mallemann/mycnc/config/grbl/README.md

# GRBL settings

Placeholder. The GRBL settings (`$$` output) of V1–V3 will be added here later.

Until then see [config/README.md](../README.md) and the [GRBL wiki](https://github.com/gnea/grbl/wiki). Adapt every value to your own machine.
