mallemann/mycnc/.github/social-preview.png

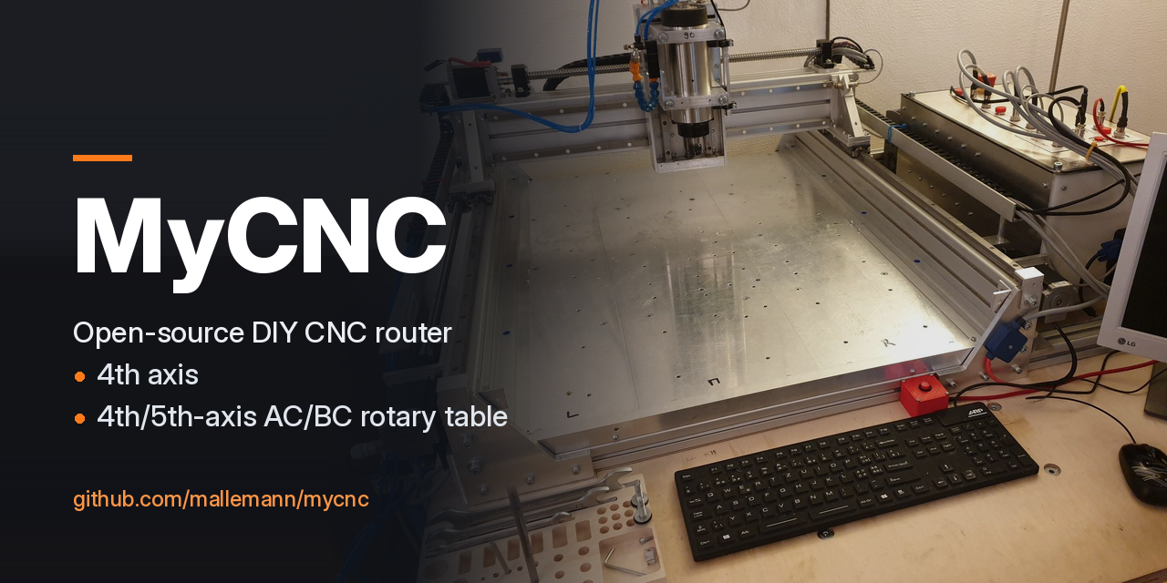
.github/social-preview.png
