mallemann/mycnc/bom/v4-structured-bom.md

# MyCNC V4 – Structured bill of materials with costs

> Generated from the Excel file [v4-structured-bom-with-costs.xlsx](v4-structured-bom-with-costs.xlsx) (original: [cnc-v4-stueckliste-mehrstufig.xlsx](https://masdrive.ch/myprojects/assets/media/2026/10/cnc-v4-stueckliste-mehrstufig.xlsx)). The nicest way to browse it – with thumbnail images – is the **[interactive view on masdrive](https://masdrive.ch/myprojects/projects/cnc-platform/#stueckliste)**.

Exported from the CAD model; all values (quantities, costs in USD, names, materials, sources) are taken unchanged from the Excel file. Part names are partly German. Costs are meant as an orientation only.

**Total cost V4 (as stated in the file): $4,238.30**

237 items in 4 levels · 8 main assemblies · 41 assemblies with sub-items (incl. the main assemblies)

## Main assemblies

| Pos. | Main assembly | Part number | Qty | Unit cost | Total |
|---|---|---|---:|---:|---:|
| 1 | Y1 Axis | SW-00070 | 1 | $295.40 | $295.40 |
| 2 | Fräskopf | SW-00087 | 1 | $511.30 | $511.30 |
| 3 | Y2 Axis | SW-00086 | 1 | $295.00 | $295.00 |
| 4 | Generic 6 Axis Controller | SW-00021 | 1 | $1,282.20 | $1,282.20 |
| 5 | Basis | SW-00007 | 1 | $65.10 | $65.10 |
| 6 | PLH3D-15W High Performance Plug&Play Laser Kit for All CNC Machines | SW-00148 | 1 | $700.00 | $700.00 |
| 7 | X Axis | SW-00104 | 1 | $571.80 | $571.80 |
| 8 | Z Axis | SW-00122 | 1 | $517.50 | $517.50 |
| | **Total (as stated in the file)** | | | | **$4,238.30** |

## Full structure

Click an assembly to expand it. Format: position, name, part number, quantity × unit cost = total.

<ul>
  <li><details><summary><b>1</b> Y1 Axis · <code>SW-00070</code> · 1 × $295.40 = <b>$295.40</b></summary>
  <ul>
    <li><b>1.1</b> LagerMotorHalterWinkel · <code>SW-00071</code> · 1 × $1.00 = <b>$1.00</b> · Material: 1060 Legierung</li>
    <li><b>1.2</b> 120x40-960 · <code>SW-00077</code> · 1 × $5.00 = <b>$5.00</b> · Material: 1060 Legierung</li>
    <li><details><summary><b>1.3</b> FestLager · <code>SW-00078</code> · 1 × $39.50 = <b>$39.50</b> · Source: <a href="https://www.dold-mechatronik.de/">dold-mechatronik.de</a></summary>
    <ul>
      <li><b>1.3.1</b> LagerMutterM10 · <code>SW-00079</code> · 1 × $0.10 = <b>$0.10</b> · Material: 201 Gehärteter Edelstahl (SS)</li>
      <li><b>1.3.2</b> FestLagerDeckel · <code>SW-00080</code> · 1 × $4.00 = <b>$4.00</b> · Material: 1023 Kohlenstoffstahlblech (SS)</li>
      <li><b>1.3.3</b> FestLagerBock · <code>SW-00081</code> · 1 × $25.00 = <b>$25.00</b> · Material: 1023 Kohlenstoffstahlblech (SS)</li>
      <li><b>1.3.4</b> SchraegLager10x30x14.3-Dold · <code>SW-00082</code> · 1 × $10.00 = <b>$10.00</b></li>
      <li><b>1.3.5</b> DIN 912 M5 x 20 --- 20N · <code>DIN 912 M5 x 20 --- 20N</code> · 4 × $0.10 = <b>$0.40</b></li>
    </ul>
    </details></li>
    <li><b>1.4</b> LagerHalterPlatteY · <code>SW-00083</code> · 1 × $1.00 = <b>$1.00</b></li>
    <li><details><summary><b>1.5</b> LosLager · <code>SW-00072</code> · 1 × $19.00 = <b>$19.00</b> · Source: <a href="https://www.dold-mechatronik.de/">dold-mechatronik.de</a></summary>
    <ul>
      <li><b>1.5.1</b> LosLagerBock · <code>SW-00073</code> · 1 × $12.00 = <b>$12.00</b> · Material: 1023 Kohlenstoffstahlblech (SS)</li>
      <li><b>1.5.2</b> KugelLagerLager10x30x9-Dold · <code>SW-00074</code> · 1 × $7.00 = <b>$7.00</b></li>
    </ul>
    </details></li>
    <li><b>1.6</b> WellenKupplung6.35-8Dold · <code>SW-00084</code> · 1 × $3.00 = <b>$3.00</b> · Material: 1060 Legierung · Source: <a href="https://www.dold-mechatronik.de/">dold-mechatronik.de</a></li>
    <li><b>1.7</b> GewindeSpindel16x5x842 · <code>SW-00075</code> · 1 × $50.00 = <b>$50.00</b> · Material: Rostfreier Chromstahl · Source: <a href="https://www.dold-mechatronik.de/">dold-mechatronik.de</a></li>
    <li><b>1.8</b> AR15-rail 960 · <code>SW-00076</code> · 1 × $64.00 = <b>$64.00</b> · Material: 1.5714 (16NiCr4) · Source: <a href="https://www.dold-mechatronik.de/">dold-mechatronik.de</a></li>
    <li><b>1.9</b> DIN 912 M6 x 10 --- 10N · <code>DIN 912 M6 x 10 --- 10N</code> · 12 × $0.10 = <b>$1.20</b></li>
    <li><b>1.10</b> DIN 912 M4 x 6 --- 6N · <code>DIN 912 M4 x 6 --- 6N</code> · 18 × $0.10 = <b>$1.80</b></li>
    <li><b>1.11</b> DIN 912 M5 x 20 --- 20N · <code>DIN 912 M5 x 20 --- 20N</code> · 4 × $0.10 = <b>$0.40</b></li>
    <li><b>1.12</b> ISO - 4033 - M5 - W - N · <code>ISO - 4033 - M5 - W - N</code> · 4 × $0.10 = <b>$0.40</b></li>
    <li><b>1.13</b> Circlip DIN 471 - 10 x 1 · <code>Circlip DIN 471 - 10 x 1</code> · 1 × $0.10 = <b>$0.10</b></li>
    <li><b>1.14</b> Closed Loop Stepper 3.6 NM on X Axis, 3NM Bipolar Stepper 3NM on Y1,Y2 and Z Axis · <code>SW-00085</code> · 1 × $109.00 = <b>$109.00</b> · Source: ebay</li>
  </ul>
  </details></li>
  <li><details><summary><b>2</b> Fräskopf · <code>SW-00087</code> · 1 × $511.30 = <b>$511.30</b></summary>
  <ul>
    <li><b>2.1</b> ARC15FN_block · <code>SW-00090</code> · 4 × $30.00 = <b>$120.00</b> · Source: <a href="https://www.dold-mechatronik.de/">dold-mechatronik.de</a></li>
    <li><b>2.2</b> MotorHalter1 · <code>SW-00089</code> · 2 × $1.00 = <b>$2.00</b> · Material: 1060 Legierung</li>
    <li><b>2.3</b> Spindle GDZ-23 · <code>SW-00092</code> · 1 × $250.00 = <b>$250.00</b> · Source: ebay</li>
    <li><details><summary><b>2.4</b> CamHalter3 · <code>SW-00093</code> · 1 × $5.20 = <b>$5.20</b></summary>
    <ul>
      <li><b>2.4.1</b> Cam · <code>SW-00094</code> · 1 × $5.00 = <b>$5.00</b> · Material: 1.5805 (10NiCr5-4)</li>
      <li><b>2.4.2</b> CamHUnten · <code>SW-00095</code> · 1 × $0.10 = <b>$0.10</b></li>
      <li><b>2.4.3</b> CamHOben · <code>SW-00096</code> · 1 × $0.10 = <b>$0.10</b></li>
    </ul>
    </details></li>
    <li><b>2.5</b> MotorHalterPlatteIsel · <code>SW-00088</code> · 1 × $1.00 = <b>$1.00</b> · Material: 1060 Legierung</li>
    <li><b>2.6</b> MotorHalter2 · <code>SW-00091</code> · 2 × $1.00 = <b>$2.00</b> · Material: 1060 Legierung</li>
    <li><details><summary><b>2.7</b> spannblock_-_213400 · <code>SW-00097</code> · 1 × $127.30 = <b>$127.30</b> · Source: <a href="https://www.dold-mechatronik.de/">dold-mechatronik.de</a></summary>
    <ul>
      <li><b>2.7.1</b> spannblock_-_213400_01 · <code>SW-00099</code> · 1 × $48.00 = <b>$48.00</b> · Source: <a href="https://www.dold-mechatronik.de/">dold-mechatronik.de</a></li>
      <li><b>2.7.2</b> spannblock_-_213400_03 · <code>SW-00101</code> · 1 × $0.10 = <b>$0.10</b></li>
      <li><b>2.7.3</b> spannblock_-_213400_04 · <code>SW-00100</code> · 1 × $0.10 = <b>$0.10</b></li>
      <li><b>2.7.4</b> spannblock_-_213400_02 · <code>SW-00098</code> · 1 × $0.10 = <b>$0.10</b></li>
      <li><b>2.7.5</b> Kugelgewindemutter 12x2,5mm, Einzelgangrückführung von Dold Mechatronic · <code>SW-00102</code> · 1 × $79.00 = <b>$79.00</b> · Material: 1.4000 (X6Cr13)</li>
    </ul>
    </details></li>
    <li><b>2.8</b> DIN 912 M8 x 80 --- 28N · <code>DIN 912 M8 x 80 --- 28N</code> · 4 × $0.10 = <b>$0.40</b></li>
    <li><b>2.9</b> DIN 912 M5 x 20 --- 20N · <code>DIN 912 M5 x 20 --- 20N</code> · 16 × $0.10 = <b>$1.60</b></li>
    <li><b>2.10</b> DIN 912 M4 x 16 --- 16N · <code>DIN 912 M4 x 16 --- 16N</code> · 4 × $0.10 = <b>$0.40</b></li>
    <li><b>2.11</b> DIN 912 M5 x 35 --- 22N · <code>DIN 912 M5 x 35 --- 22N</code> · 4 × $0.10 = <b>$0.40</b></li>
    <li><b>2.12</b> LaserHalter1 · <code>SW-00103</code> · 1 × $1.00 = <b>$1.00</b></li>
  </ul>
  </details></li>
  <li><details><summary><b>3</b> Y2 Axis · <code>SW-00086</code> · 1 × $295.00 = <b>$295.00</b></summary>
  <ul>
    <li><b>3.1</b> AR15-rail 960 · <code>SW-00076</code> · 1 × $64.00 = <b>$64.00</b> · Material: 1.5714 (16NiCr4) · Source: <a href="https://www.dold-mechatronik.de/">dold-mechatronik.de</a></li>
    <li><details><summary><b>3.2</b> FestLager · <code>SW-00078</code> · 1 × $39.50 = <b>$39.50</b> · Source: <a href="https://www.dold-mechatronik.de/">dold-mechatronik.de</a></summary>
    <ul>
      <li><b>3.2.1</b> LagerMutterM10 · <code>SW-00079</code> · 1 × $0.10 = <b>$0.10</b> · Material: 201 Gehärteter Edelstahl (SS)</li>
      <li><b>3.2.2</b> FestLagerDeckel · <code>SW-00080</code> · 1 × $4.00 = <b>$4.00</b> · Material: 1023 Kohlenstoffstahlblech (SS)</li>
      <li><b>3.2.3</b> FestLagerBock · <code>SW-00081</code> · 1 × $25.00 = <b>$25.00</b> · Material: 1023 Kohlenstoffstahlblech (SS)</li>
      <li><b>3.2.4</b> SchraegLager10x30x14.3-Dold · <code>SW-00082</code> · 1 × $10.00 = <b>$10.00</b></li>
      <li><b>3.2.5</b> DIN 912 M5 x 20 --- 20N · <code>DIN 912 M5 x 20 --- 20N</code> · 4 × $0.10 = <b>$0.40</b></li>
    </ul>
    </details></li>
    <li><b>3.3</b> 120x40-960 · <code>SW-00077</code> · 1 × $5.00 = <b>$5.00</b> · Material: 1060 Legierung</li>
    <li><b>3.4</b> DIN 912 M6 x 10 --- 10N · <code>DIN 912 M6 x 10 --- 10N</code> · 12 × $0.10 = <b>$1.20</b></li>
    <li><details><summary><b>3.5</b> LosLager · <code>SW-00072</code> · 1 × $19.00 = <b>$19.00</b> · Source: <a href="https://www.dold-mechatronik.de/">dold-mechatronik.de</a></summary>
    <ul>
      <li><b>3.5.1</b> LosLagerBock · <code>SW-00073</code> · 1 × $12.00 = <b>$12.00</b> · Material: 1023 Kohlenstoffstahlblech (SS)</li>
      <li><b>3.5.2</b> KugelLagerLager10x30x9-Dold · <code>SW-00074</code> · 1 × $7.00 = <b>$7.00</b></li>
    </ul>
    </details></li>
    <li><b>3.6</b> GewindeSpindel16x5x842 · <code>SW-00075</code> · 1 × $50.00 = <b>$50.00</b> · Material: Rostfreier Chromstahl · Source: <a href="https://www.dold-mechatronik.de/">dold-mechatronik.de</a></li>
    <li><b>3.7</b> LagerMotorHalterWinkel · <code>SW-00071</code> · 1 × $1.00 = <b>$1.00</b> · Material: 1060 Legierung</li>
    <li><b>3.8</b> WellenKupplung6.35-8Dold · <code>SW-00084</code> · 1 × $3.00 = <b>$3.00</b> · Material: 1060 Legierung · Source: <a href="https://www.dold-mechatronik.de/">dold-mechatronik.de</a></li>
    <li><b>3.9</b> LagerHalterPlatteY · <code>SW-00083</code> · 1 × $1.00 = <b>$1.00</b></li>
    <li><b>3.10</b> Closed Loop Stepper 3.6 NM on X Axis, 3NM Bipolar Stepper 3NM on Y1,Y2 and Z Axis · <code>SW-00085</code> · 1 × $109.00 = <b>$109.00</b> · Source: ebay</li>
    <li><b>3.11</b> DIN 912 M4 x 10 --- 10N · <code>DIN 912 M4 x 10 --- 10N</code> · 16 × $0.10 = <b>$1.60</b></li>
    <li><b>3.12</b> Circlip DIN 471 - 10 x 1 · <code>Circlip DIN 471 - 10 x 1</code> · 1 × $0.10 = <b>$0.10</b></li>
    <li><b>3.13</b> DIN 912 M5 x 20 --- 20N · <code>DIN 912 M5 x 20 --- 20N</code> · 4 × $0.10 = <b>$0.40</b></li>
    <li><b>3.14</b> DIN 912 M4 x 16 --- 16N · <code>DIN 912 M4 x 16 --- 16N</code> · 2 × $0.10 = <b>$0.20</b></li>
  </ul>
  </details></li>
  <li><details><summary><b>4</b> Generic 6 Axis Controller · <code>SW-00021</code> · 1 × $1,282.20 = <b>$1,282.20</b></summary>
  <ul>
    <li><details><summary><b>4.1</b> Boards · <code>SW-00028</code> · 1 × $348.00 = <b>$348.00</b></summary>
    <ul>
      <li><b>4.1.1</b> UB1 motherboard from cncroom · <code>SW-00029</code> · 1 × $196.00 = <b>$196.00</b> · Source: <a href="https://cncroom.com/en/">cncroom.com/en</a></li>
      <li><b>4.1.2</b> UC300ETH-5LPT MOtion Controller from CNCDrive · <code>SW-00030</code> · 1 × $152.00 = <b>$152.00</b> · Source: <a href="https://www.cncdrive.com/">cncdrive.com</a></li>
    </ul>
    </details></li>
    <li><details><summary><b>4.2</b> Driver · <code>SW-00049</code> · 1 × $330.00 = <b>$330.00</b></summary>
    <ul>
      <li><b>4.2.1</b> DQ542MA CNC Digital Stepper Motor Controller 50V/4.2A/128 Micro · <code>SW-00050</code> · 6 × $55.00 = <b>$330.00</b> · Source: ebay</li>
    </ul>
    </details></li>
    <li><details><summary><b>4.3</b> Stecker · <code>SW-00031</code> · 1 × $43.80 = <b>$43.80</b></summary>
    <ul>
      <li><details><summary><b>4.3.1</b> Buchse2P v2 · <code>SW-00039</code> · 1 × $1.20 = <b>$1.20</b></summary>
      <ul>
        <li><b>4.3.1.1</b> 4 pin aviation f · <code>SW-00033</code> · 1 × $0.50 = <b>$0.50</b></li>
        <li><b>4.3.1.2</b> 4 pin aviation spring washer · <code>SW-00035</code> · 1 × $0.10 = <b>$0.10</b></li>
        <li><b>4.3.1.3</b> 2 pin aviation f plastic · <code>SW-00034</code> · 1 × $0.50 = <b>$0.50</b></li>
        <li><b>4.3.1.4</b> 4 pin aviation nut · <code>SW-00036</code> · 1 × $0.10 = <b>$0.10</b></li>
      </ul>
      </details></li>
      <li><details><summary><b>4.3.2</b> Buchse4P v2 · <code>SW-00041</code> · 6 × $5.70 = <b>$34.20</b></summary>
      <ul>
        <li><b>4.3.2.1</b> 4 pin aviation f plastic · <code>SW-00043</code> · 1 × $0.50 = <b>$0.50</b></li>
        <li><b>4.3.2.2</b> 4 pin aviation f-1 · <code>SW-00042</code> · 1 × $5.00 = <b>$5.00</b></li>
        <li><b>4.3.2.3</b> 4 pin aviation spring washer-1 · <code>SW-00044</code> · 1 × $0.10 = <b>$0.10</b></li>
        <li><b>4.3.2.4</b> 4 pin aviation nut-1 · <code>SW-00045</code> · 1 × $0.10 = <b>$0.10</b></li>
      </ul>
      </details></li>
      <li><details><summary><b>4.3.3</b> Buchse2P v2-1 · <code>SW-00040</code> · 1 × $1.20 = <b>$1.20</b></summary>
      <ul>
        <li><b>4.3.3.1</b> 4 pin aviation f · <code>SW-00033</code> · 1 × $0.50 = <b>$0.50</b></li>
        <li><b>4.3.3.2</b> 4 pin aviation spring washer · <code>SW-00035</code> · 1 × $0.10 = <b>$0.10</b></li>
        <li><b>4.3.3.3</b> 4 pin aviation nut · <code>SW-00036</code> · 1 × $0.10 = <b>$0.10</b></li>
        <li><b>4.3.3.4</b> 2 pin aviation f plastic · <code>SW-00034</code> · 1 × $0.50 = <b>$0.50</b></li>
      </ul>
      </details></li>
      <li><details><summary><b>4.3.4</b> Buchse2P v2-3 · <code>SW-00047</code> · 1 × $1.20 = <b>$1.20</b></summary>
      <ul>
        <li><b>4.3.4.1</b> 2 pin aviation f plastic · <code>SW-00034</code> · 1 × $0.50 = <b>$0.50</b></li>
        <li><b>4.3.4.2</b> 4 pin aviation f · <code>SW-00033</code> · 1 × $0.50 = <b>$0.50</b></li>
        <li><b>4.3.4.3</b> 4 pin aviation spring washer · <code>SW-00035</code> · 1 × $0.10 = <b>$0.10</b></li>
        <li><b>4.3.4.4</b> 4 pin aviation nut · <code>SW-00036</code> · 1 × $0.10 = <b>$0.10</b></li>
      </ul>
      </details></li>
      <li><details><summary><b>4.3.5</b> Buchse2P v2-2 · <code>SW-00046</code> · 1 × $1.20 = <b>$1.20</b></summary>
      <ul>
        <li><b>4.3.5.1</b> 4 pin aviation spring washer · <code>SW-00035</code> · 1 × $0.10 = <b>$0.10</b></li>
        <li><b>4.3.5.2</b> 4 pin aviation nut · <code>SW-00036</code> · 1 × $0.10 = <b>$0.10</b></li>
        <li><b>4.3.5.3</b> 2 pin aviation f plastic · <code>SW-00034</code> · 1 × $0.50 = <b>$0.50</b></li>
        <li><b>4.3.5.4</b> 4 pin aviation f · <code>SW-00033</code> · 1 × $0.50 = <b>$0.50</b></li>
      </ul>
      </details></li>
      <li><details><summary><b>4.3.6</b> Buchse2P v2-4 · <code>SW-00032</code> · 1 × $1.20 = <b>$1.20</b></summary>
      <ul>
        <li><b>4.3.6.1</b> 4 pin aviation f · <code>SW-00033</code> · 1 × $0.50 = <b>$0.50</b></li>
        <li><b>4.3.6.2</b> 4 pin aviation nut · <code>SW-00036</code> · 1 × $0.10 = <b>$0.10</b></li>
        <li><b>4.3.6.3</b> 2 pin aviation f plastic · <code>SW-00034</code> · 1 × $0.50 = <b>$0.50</b></li>
        <li><b>4.3.6.4</b> 4 pin aviation spring washer · <code>SW-00035</code> · 1 × $0.10 = <b>$0.10</b></li>
      </ul>
      </details></li>
      <li><details><summary><b>4.3.7</b> Buchse2P v2-7 · <code>SW-00038</code> · 1 × $1.20 = <b>$1.20</b></summary>
      <ul>
        <li><b>4.3.7.1</b> 2 pin aviation f plastic · <code>SW-00034</code> · 1 × $0.50 = <b>$0.50</b></li>
        <li><b>4.3.7.2</b> 4 pin aviation nut · <code>SW-00036</code> · 1 × $0.10 = <b>$0.10</b></li>
        <li><b>4.3.7.3</b> 4 pin aviation f · <code>SW-00033</code> · 1 × $0.50 = <b>$0.50</b></li>
        <li><b>4.3.7.4</b> 4 pin aviation spring washer · <code>SW-00035</code> · 1 × $0.10 = <b>$0.10</b></li>
      </ul>
      </details></li>
      <li><details><summary><b>4.3.8</b> Buchse2P v2-6 · <code>SW-00037</code> · 1 × $1.20 = <b>$1.20</b></summary>
      <ul>
        <li><b>4.3.8.1</b> 4 pin aviation f · <code>SW-00033</code> · 1 × $0.50 = <b>$0.50</b></li>
        <li><b>4.3.8.2</b> 2 pin aviation f plastic · <code>SW-00034</code> · 1 × $0.50 = <b>$0.50</b></li>
        <li><b>4.3.8.3</b> 4 pin aviation spring washer · <code>SW-00035</code> · 1 × $0.10 = <b>$0.10</b></li>
        <li><b>4.3.8.4</b> 4 pin aviation nut · <code>SW-00036</code> · 1 × $0.10 = <b>$0.10</b></li>
      </ul>
      </details></li>
      <li><details><summary><b>4.3.9</b> Buchse2P v2-5 · <code>SW-00048</code> · 1 × $1.20 = <b>$1.20</b></summary>
      <ul>
        <li><b>4.3.9.1</b> 4 pin aviation nut · <code>SW-00036</code> · 1 × $0.10 = <b>$0.10</b></li>
        <li><b>4.3.9.2</b> 2 pin aviation f plastic · <code>SW-00034</code> · 1 × $0.50 = <b>$0.50</b></li>
        <li><b>4.3.9.3</b> 4 pin aviation spring washer · <code>SW-00035</code> · 1 × $0.10 = <b>$0.10</b></li>
        <li><b>4.3.9.4</b> 4 pin aviation f · <code>SW-00033</code> · 1 × $0.50 = <b>$0.50</b></li>
      </ul>
      </details></li>
    </ul>
    </details></li>
    <li><details><summary><b>4.4</b> Gehaeuse-Profil v40 · <code>SW-00052</code> · 1 × $58.40 = <b>$58.40</b></summary>
    <ul>
      <li><b>4.4.1</b> 30x30-224 v2 · <code>SW-00053</code> · 4 × $5.00 = <b>$20.00</b> · Material: 3.3547 (EN-AW 5083)</li>
      <li><b>4.4.2</b> FanDeckel · <code>SW-00068</code> · 1 × $1.00 = <b>$1.00</b></li>
      <li><details><summary><b>4.4.3</b> Hutschienen · <code>SW-00055</code> · 1 × $4.00 = <b>$4.00</b></summary>
      <ul>
        <li><b>4.4.3.1</b> Schiene · <code>SW-00056</code> · 2 × $2.00 = <b>$4.00</b></li>
      </ul>
      </details></li>
      <li><b>4.4.4</b> WandGeraeteStecker_1 · <code>SW-00066</code> · 1 × $1.00 = <b>$1.00</b> · Material: 1060 Legierung</li>
      <li><b>4.4.5</b> Boden · <code>SW-00057</code> · 1 × $1.00 = <b>$1.00</b></li>
      <li><b>4.4.6</b> WandPlexi · <code>SW-00054</code> · 1 × $1.00 = <b>$1.00</b> · Material: Glas</li>
      <li><details><summary><b>4.4.7</b> Schrauben · <code>SW-00060</code> · 1 × $2.40 = <b>$2.40</b></summary>
      <ul>
        <li><b>4.4.7.1</b> 91292A116 · <code>SW-00062</code> · 16 × $0.10 = <b>$1.60</b></li>
        <li><b>4.4.7.2</b> 91239A412 · <code>SW-00061</code> · 4 × $0.10 = <b>$0.40</b></li>
        <li><b>4.4.7.3</b> 9546K241 · <code>SW-00063</code> · 4 × $0.10 = <b>$0.40</b></li>
      </ul>
      </details></li>
      <li><b>4.4.8</b> WandDriver · <code>SW-00058</code> · 1 × $1.00 = <b>$1.00</b> · Material: 1060 Legierung</li>
      <li><b>4.4.9</b> WandKurz2_1 · <code>SW-00059</code> · 1 × $1.00 = <b>$1.00</b> · Material: 1060 Legierung</li>
      <li><b>4.4.10</b> Deckel · <code>SW-00065</code> · 1 × $1.00 = <b>$1.00</b> · Material: 1060 Legierung</li>
      <li><b>4.4.11</b> power socket w fuse v1 · <code>SW-00064</code> · 1 × $5.00 = <b>$5.00</b></li>
      <li><b>4.4.12</b> E-StopAutomationDirectGCX1131 v1 · <code>SW-00067</code> · 1 × $10.00 = <b>$10.00</b></li>
      <li><b>4.4.13</b> GDSTIME 50mm x 50mm x 20mm 12V Brushless Cooling Fan v2 · <code>SW-00069</code> · 1 × $10.00 = <b>$10.00</b></li>
    </ul>
    </details></li>
    <li><details><summary><b>4.5</b> Power Supply · <code>SW-00022</code> · 1 × $152.00 = <b>$152.00</b></summary>
    <ul>
      <li><b>4.5.1</b> wago_222_5_terminal v1 · <code>SW-00026</code> · 3 × $1.00 = <b>$3.00</b></li>
      <li><b>4.5.2</b> 48V Power Supply for Stepper · <code>SW-00024</code> · 2 × $45.00 = <b>$90.00</b> · Source: ebay</li>
      <li><b>4.5.3</b> 5V Power Supply · <code>SW-00025</code> · 1 × $25.00 = <b>$25.00</b> · Source: ebay</li>
      <li><b>4.5.4</b> 24V Power Supply for UB1 motion controller · <code>SW-00023</code> · 1 × $22.00 = <b>$22.00</b> · Source: ebay</li>
      <li><b>4.5.5</b> 12V Power Supply for Laser Module · <code>SW-00027</code> · 1 × $12.00 = <b>$12.00</b> · Source: ebay</li>
    </ul>
    </details></li>
    <li><b>4.6</b> Windows 11 PC für UCCNC · <code>SW-00051</code> · 1 × $350.00 = <b>$350.00</b></li>
  </ul>
  </details></li>
  <li><details><summary><b>5</b> Basis · <code>SW-00007</code> · 1 × $65.10 = <b>$65.10</b></summary>
  <ul>
    <li><b>5.1</b> 40x40-1100 · <code>SW-00008</code> · 5 × $5.00 = <b>$25.00</b> · Material: 1060 Legierung</li>
    <li><b>5.2</b> 160x150x40x10 · <code>SW-00010</code> · 4 × $1.00 = <b>$4.00</b> · Material: 1060 Legierung</li>
    <li><b>5.3</b> 8x70x960 · <code>SW-00011</code> · 1 × $2.00 = <b>$2.00</b> · Material: 1060 Legierung</li>
    <li><b>5.4</b> Winkel40x40x8 · <code>SW-00009</code> · 1 × $2.00 = <b>$2.00</b> · Material: 1060 Legierung</li>
    <li><b>5.5</b> Halter · <code>SW-00013</code> · 2 × $0.10 = <b>$0.20</b></li>
    <li><b>5.6</b> SteuerungDistanzhalter · <code>SW-00012</code> · 2 × $0.10 = <b>$0.20</b></li>
    <li><details><summary><b>5.7</b> Schrauben^BasisGestell · <code>SW-00014</code> · 1 × $8.70 = <b>$8.70</b></summary>
    <ul>
      <li><b>5.7.1</b> DIN 7991 - M6 x 20 --- 13.7N · <code>DIN 7991 - M6 x 20 --- 13.7N</code> · 25 × $0.10 = <b>$2.50</b></li>
      <li><b>5.7.2</b> DIN 912 M6 x 10 --- 10N · <code>DIN 912 M6 x 10 --- 10N</code> · 50 × $0.10 = <b>$5.00</b></li>
      <li><b>5.7.3</b> DIN 912 M8 x 12 --- 12N · <code>DIN 912 M8 x 12 --- 12N</code> · 12 × $0.10 = <b>$1.20</b></li>
    </ul>
    </details></li>
    <li><b>5.8</b> GrundgestellVerstärker · <code>SW-00015</code> · 2 × $2.00 = <b>$4.00</b> · Material: 1060 Legierung</li>
    <li><details><summary><b>5.9</b> AluBP · <code>SW-00017</code> · 1 × $3.00 = <b>$3.00</b></summary>
    <ul>
      <li><b>5.9.1</b> AluBP150 · <code>SW-00019</code> · 1 × $1.00 = <b>$1.00</b> · Material: 1060 Legierung</li>
      <li><b>5.9.2</b> AluBP250 · <code>SW-00018</code> · 2 × $1.00 = <b>$2.00</b> · Material: 1060 Legierung</li>
    </ul>
    </details></li>
    <li><b>5.10</b> InduktivSensor · <code>SW-00016</code> · 1 × $15.00 = <b>$15.00</b> · Source: <a href="https://www.dold-mechatronik.de/">dold-mechatronik.de</a></li>
    <li><b>5.11</b> SensorPlatte · <code>SW-00020</code> · 1 × $1.00 = <b>$1.00</b> · Material: 3.3547 (EN-AW 5083)</li>
  </ul>
  </details></li>
  <li><b>6</b> PLH3D-15W High Performance Plug&amp;Play Laser Kit for All CNC Machines · <code>SW-00148</code> · 1 × $700.00 = <b>$700.00</b> · Source: <a href="https://optlasers.com/">optlasers.com</a></li>
  <li><details><summary><b>7</b> X Axis · <code>SW-00104</code> · 1 × $571.80 = <b>$571.80</b></summary>
  <ul>
    <li><details><summary><b>7.1</b> FestLager · <code>SW-00078</code> · 1 × $39.50 = <b>$39.50</b> · Source: <a href="https://www.dold-mechatronik.de/">dold-mechatronik.de</a></summary>
    <ul>
      <li><b>7.1.1</b> LagerMutterM10 · <code>SW-00079</code> · 1 × $0.10 = <b>$0.10</b> · Material: 201 Gehärteter Edelstahl (SS)</li>
      <li><b>7.1.2</b> FestLagerDeckel · <code>SW-00080</code> · 1 × $4.00 = <b>$4.00</b> · Material: 1023 Kohlenstoffstahlblech (SS)</li>
      <li><b>7.1.3</b> FestLagerBock · <code>SW-00081</code> · 1 × $25.00 = <b>$25.00</b> · Material: 1023 Kohlenstoffstahlblech (SS)</li>
      <li><b>7.1.4</b> SchraegLager10x30x14.3-Dold · <code>SW-00082</code> · 1 × $10.00 = <b>$10.00</b></li>
      <li><b>7.1.5</b> DIN 912 M5 x 20 --- 20N · <code>DIN 912 M5 x 20 --- 20N</code> · 4 × $0.10 = <b>$0.40</b></li>
    </ul>
    </details></li>
    <li><b>7.2</b> DIN 912 M5 x 20 --- 20N · <code>DIN 912 M5 x 20 --- 20N</code> · 49 × $0.10 = <b>$4.90</b></li>
    <li><details><summary><b>7.3</b> XSchrauben · <code>SW-00116</code> · 1 × $4.90 = <b>$4.90</b></summary>
    <ul>
      <li><b>7.3.1</b> DIN 912 M5 x 20 --- 20N · <code>DIN 912 M5 x 20 --- 20N</code> · 25 × $0.10 = <b>$2.50</b></li>
      <li><b>7.3.2</b> DIN 912 M4 x 16 --- 16N · <code>DIN 912 M4 x 16 --- 16N</code> · 24 × $0.10 = <b>$2.40</b></li>
    </ul>
    </details></li>
    <li><b>7.4</b> LagerMotorHalterWinkel · <code>SW-00071</code> · 1 × $1.00 = <b>$1.00</b> · Material: 1060 Legierung</li>
    <li><details><summary><b>7.5</b> LosLager · <code>SW-00072</code> · 1 × $19.00 = <b>$19.00</b> · Source: <a href="https://www.dold-mechatronik.de/">dold-mechatronik.de</a></summary>
    <ul>
      <li><b>7.5.1</b> LosLagerBock · <code>SW-00073</code> · 1 × $12.00 = <b>$12.00</b> · Material: 1023 Kohlenstoffstahlblech (SS)</li>
      <li><b>7.5.2</b> KugelLagerLager10x30x9-Dold · <code>SW-00074</code> · 1 × $7.00 = <b>$7.00</b></li>
    </ul>
    </details></li>
    <li><b>7.6</b> XMitnehmerStuetze · <code>SW-00114</code> · 2 × $1.00 = <b>$2.00</b></li>
    <li><b>7.7</b> WellenKupplung6.35-8Dold · <code>SW-00084</code> · 1 × $3.00 = <b>$3.00</b> · Material: 1060 Legierung · Source: <a href="https://www.dold-mechatronik.de/">dold-mechatronik.de</a></li>
    <li><b>7.8</b> LagerHalterPlatte · <code>SW-00117</code> · 1 × $1.00 = <b>$1.00</b> · Material: 1060 Legierung</li>
    <li><details><summary><b>7.9</b> X-WinkelBG · <code>SW-00118</code> · 2 × $3.00 = <b>$6.00</b></summary>
    <ul>
      <li><b>7.9.1</b> X-Platte2 · <code>SW-00120</code> · 1 × $1.00 = <b>$1.00</b> · Material: 1060 Legierung</li>
      <li><b>7.9.2</b> X-Platte1 · <code>SW-00119</code> · 1 × $1.00 = <b>$1.00</b> · Material: 1060 Legierung</li>
      <li><b>7.9.3</b> X-Winkel · <code>SW-00121</code> · 1 × $1.00 = <b>$1.00</b> · Material: 1060 Legierung</li>
    </ul>
    </details></li>
    <li><b>7.10</b> InduktivSensor · <code>SW-00016</code> · 1 × $15.00 = <b>$15.00</b> · Source: <a href="https://www.dold-mechatronik.de/">dold-mechatronik.de</a></li>
    <li><b>7.11</b> Closed Loop Stepper 3.6 NM on X Axis, 3NM Bipolar Stepper 3NM on Y1,Y2 and Z Axis · <code>SW-00085</code> · 1 × $109.00 = <b>$109.00</b> · Source: ebay</li>
    <li><b>7.12</b> DIN 912 M6 x 10 --- 10N · <code>DIN 912 M6 x 10 --- 10N</code> · 4 × $0.10 = <b>$0.40</b></li>
    <li><b>7.13</b> ARC15FN_block · <code>SW-00090</code> · 4 × $30.00 = <b>$120.00</b> · Source: <a href="https://www.dold-mechatronik.de/">dold-mechatronik.de</a></li>
    <li><b>7.14</b> 120x80-800 · <code>SW-00105</code> · 1 × $8.00 = <b>$8.00</b> · Material: 1060 Legierung</li>
    <li><b>7.15</b> AR15-rail 690 · <code>SW-00107</code> · 2 × $56.00 = <b>$112.00</b> · Material: 1.5714 (16NiCr4)</li>
    <li><b>7.16</b> GewindeSpindel16x5x652 · <code>SW-00106</code> · 1 × $40.00 = <b>$40.00</b> · Material: Rostfreier Chromstahl</li>
    <li><details><summary><b>7.17</b> XYVerbinder · <code>SW-00110</code> · 2 × $2.00 = <b>$4.00</b></summary>
    <ul>
      <li><b>7.17.1</b> XYVerbinderplatte · <code>SW-00112</code> · 1 × $1.00 = <b>$1.00</b> · Material: 1060 Legierung</li>
      <li><b>7.17.2</b> XYWinkel · <code>SW-00111</code> · 1 × $1.00 = <b>$1.00</b></li>
    </ul>
    </details></li>
    <li><b>7.18</b> GewindeMutter16x5 · <code>SW-00115</code> · 2 × $20.00 = <b>$40.00</b> · Material: 1.5714 (16NiCr4) · Source: <a href="https://www.dold-mechatronik.de/">dold-mechatronik.de</a></li>
    <li><b>7.19</b> GewindeSpindelMutter · <code>SW-00108</code> · 2 × $19.00 = <b>$38.00</b> · Material: 1023 Kohlenstoffstahlblech (SS) · Source: <a href="https://www.dold-mechatronik.de/">dold-mechatronik.de</a></li>
    <li><b>7.20</b> XMitnehmerWinkel · <code>SW-00113</code> · 2 × $1.00 = <b>$2.00</b></li>
    <li><b>7.21</b> XMitnehmerPlatte · <code>SW-00109</code> · 2 × $1.00 = <b>$2.00</b> · Material: 1060 Legierung</li>
    <li><b>7.22</b> Circlip DIN 471 - 10 x 1 · <code>Circlip DIN 471 - 10 x 1</code> · 1 × $0.10 = <b>$0.10</b></li>
  </ul>
  </details></li>
  <li><details><summary><b>8</b> Z Axis · <code>SW-00122</code> · 1 × $517.50 = <b>$517.50</b></summary>
  <ul>
    <li><details><summary><b>8.1</b> Schrauben Z Achse Komplett Isel · <code>SW-00138</code> · 1 × $5.40 = <b>$5.40</b></summary>
    <ul>
      <li><b>8.1.1</b> DIN 912 M6 x 30 --- 30N · <code>DIN 912 M6 x 30 --- 30N</code> · 6 × $0.10 = <b>$0.60</b></li>
      <li><b>8.1.2</b> DIN 912 M4 x 16 --- 16N · <code>DIN 912 M4 x 16 --- 16N</code> · 4 × $0.10 = <b>$0.40</b></li>
      <li><b>8.1.3</b> DIN 912 M4 x 30 --- 20N · <code>DIN 912 M4 x 30 --- 20N</code> · 10 × $0.10 = <b>$1.00</b></li>
      <li><b>8.1.4</b> DIN 912 M5 x 25 --- 25N · <code>DIN 912 M5 x 25 --- 25N</code> · 16 × $0.10 = <b>$1.60</b></li>
      <li><b>8.1.5</b> DIN 912 M5 x 20 --- 20N · <code>DIN 912 M5 x 20 --- 20N</code> · 6 × $0.10 = <b>$0.60</b></li>
      <li><b>8.1.6</b> DIN 912 M4 x 10 --- 10N · <code>DIN 912 M4 x 10 --- 10N</code> · 4 × $0.10 = <b>$0.40</b></li>
      <li><b>8.1.7</b> DIN 912 M6 x 40 --- 24N · <code>DIN 912 M6 x 40 --- 24N</code> · 4 × $0.10 = <b>$0.40</b></li>
      <li><b>8.1.8</b> DIN 912 M4 x 40 --- 20N · <code>DIN 912 M4 x 40 --- 20N</code> · 4 × $0.10 = <b>$0.40</b></li>
    </ul>
    </details></li>
    <li><details><summary><b>8.2</b> Nema23mitHalter · <code>SW-00141</code> · 1 × $115.10 = <b>$115.10</b></summary>
    <ul>
      <li><b>8.2.1</b> DIN 912 M5 x 50 --- 22N · <code>DIN 912 M5 x 50 --- 22N</code> · 4 × $0.10 = <b>$0.40</b></li>
      <li><b>8.2.2</b> Closed Loop Stepper 3.6 NM on X Axis, 3NM Bipolar Stepper 3NM on Y1,Y2 and Z Axis · <code>SW-00085</code> · 1 × $109.00 = <b>$109.00</b> · Source: ebay</li>
      <li><details><summary><b>8.2.3</b> L30xD25 CouplerASM 6to8 · <code>SW-00142</code> · 1 × $3.70 = <b>$3.70</b> · Source: <a href="https://www.dold-mechatronik.de/">dold-mechatronik.de</a></summary>
      <ul>
        <li><b>8.2.3.1</b> M3x12_Screw · <code>SW-00146</code> · 2 × $0.10 = <b>$0.20</b></li>
        <li><b>8.2.3.2</b> Coupler_A · <code>SW-00143</code> · 1 × $2.00 = <b>$2.00</b></li>
        <li><b>8.2.3.3</b> Dampener · <code>SW-00144</code> · 1 × $0.50 = <b>$0.50</b></li>
        <li><b>8.2.3.4</b> Coupler_B · <code>SW-00145</code> · 1 × $1.00 = <b>$1.00</b></li>
      </ul>
      </details></li>
      <li><b>8.2.4</b> Nema23HalterFuss · <code>SW-00147</code> · 2 × $1.00 = <b>$2.00</b> · Material: 3.3547 (EN-AW 5083)</li>
    </ul>
    </details></li>
    <li><b>8.3</b> InduktivSensor · <code>SW-00016</code> · 1 × $15.00 = <b>$15.00</b> · Source: <a href="https://www.dold-mechatronik.de/">dold-mechatronik.de</a></li>
    <li><b>8.4</b> LosLagerHalterIsel · <code>SW-00127</code> · 1 × $1.00 = <b>$1.00</b> · Material: 3.3547 (EN-AW 5083)</li>
    <li><b>8.5</b> FestLagerHalterIsel · <code>SW-00128</code> · 1 × $1.00 = <b>$1.00</b> · Material: 3.3547 (EN-AW 5083)</li>
    <li><b>8.6</b> kugelgewindespindeln-211122_20352 · <code>SW-00140</code> · 1 × $37.00 = <b>$37.00</b> · Material: Werkstoff CF 53, induktiv gehärtet · Source: <a href="https://www.dold-mechatronik.de/">dold-mechatronik.de</a></li>
    <li><b>8.7</b> FestLagerBlock · <code>SW-00126</code> · 1 × $2.00 = <b>$2.00</b> · Material: 3.3547 (EN-AW 5083)</li>
    <li><b>8.8</b> SensorPlatteZ · <code>SW-00139</code> · 1 × $1.00 = <b>$1.00</b> · Material: 3.3547 (EN-AW 5083)</li>
    <li><b>8.9</b> ARC15FN_block · <code>SW-00090</code> · 4 × $30.00 = <b>$120.00</b> · Source: <a href="https://www.dold-mechatronik.de/">dold-mechatronik.de</a></li>
    <li><b>8.10</b> ZFuehrungsHalter · <code>SW-00123</code> · 1 × $1.00 = <b>$1.00</b> · Material: 3.3547 (EN-AW 5083)</li>
    <li><b>8.11</b> AR15-rail 270 · <code>SW-00125</code> · 2 × $24.00 = <b>$48.00</b> · Material: 1.5714 (16NiCr4)</li>
    <li><b>8.12</b> GewindeSpindelMutter · <code>SW-00108</code> · 1 × $19.00 = <b>$19.00</b> · Material: 1023 Kohlenstoffstahlblech (SS) · Source: <a href="https://www.dold-mechatronik.de/">dold-mechatronik.de</a></li>
    <li><b>8.13</b> ZXVerbinder · <code>SW-00124</code> · 2 × $1.00 = <b>$2.00</b> · Material: 1060 Legierung</li>
    <li><b>8.14</b> GewindeMutter16x5 · <code>SW-00115</code> · 1 × $20.00 = <b>$20.00</b> · Material: 1.5714 (16NiCr4) · Source: <a href="https://www.dold-mechatronik.de/">dold-mechatronik.de</a></li>
    <li><details><summary><b>8.15</b> Flanschlager an Antriebsseite für Spindel Ø12mm, eckig von Dold Mechatronic · <code>SW-00133</code> · 1 × $75.00 = <b>$75.00</b> · Source: <a href="https://www.dold-mechatronik.de/">dold-mechatronik.de</a></summary>
    <ul>
      <li><b>8.15.1</b> flanschlager_-_216504_0030_02 · <code>SW-00136</code> · 1 × $20.00 = <b>$20.00</b></li>
      <li><b>8.15.2</b> flanschlager_-_216504_0030_01 · <code>SW-00135</code> · 1 × $20.00 = <b>$20.00</b></li>
      <li><b>8.15.3</b> flanschlager_-_216504_0030_04 · <code>SW-00134</code> · 1 × $15.00 = <b>$15.00</b></li>
      <li><b>8.15.4</b> flanschlager_-_216504_0030_03 · <code>SW-00137</code> · 1 × $20.00 = <b>$20.00</b></li>
    </ul>
    </details></li>
    <li><details><summary><b>8.16</b> Flanschlager an Loslagerseite für Spindel Ø12mm von Dold Mechatronic · <code>SW-00129</code> · 1 × $55.00 = <b>$55.00</b> · Source: <a href="https://www.dold-mechatronik.de/">dold-mechatronik.de</a></summary>
    <ul>
      <li><b>8.16.1</b> flanschlager_-_216504_0032_02 · <code>SW-00132</code> · 1 × $15.00 = <b>$15.00</b></li>
      <li><b>8.16.2</b> flanschlager_-_216504_0032_01 · <code>SW-00130</code> · 1 × $20.00 = <b>$20.00</b></li>
      <li><b>8.16.3</b> flanschlager_-_216504_0032_03 · <code>SW-00131</code> · 1 × $20.00 = <b>$20.00</b></li>
    </ul>
    </details></li>
  </ul>
  </details></li>
</ul>

---

*Source: [masdrive.ch – Komplette Stückliste der V4](https://masdrive.ch/myprojects/projects/cnc-platform/#stueckliste). Also available as PDF: [structure (multi-level)](v4-bom-multi-level.pdf) · [assembly overview (single-level)](v4-bom-single-level.pdf) · [quantities](v4-bom-quantities.pdf).*
