mallemann/mycnc/bom/v4-bom-quantities.pdf

Part Number | Thumbnail image | Quantity | Total Cost | Description | Cost | File Name | Type | Material | Source
SW-00070 | 1 | $295.40 Y1 Axis | $295.40 Y1-Achse.SLDASM | Assembly
SW-00071 | 3 | $3.00 | $1.00 LagerMotorHalterWinkel.SLDPRT | Part | 1060 Legierung
SW-00077 | 2 | $10.00 | $5.00 120x40-960.SLDPRT | Part | 1060 Legierung
SW-00078 | 3 | $118.50 | $39.50 FestLager.SLDASM | Assembly | https://www.dold-mechatronik.de/
SW-00079 | 3 | $0.30 | $0.10 LagerMutterM10.SLDPRT | Part | 201 Gehärteter Edelstahl (SS)
SW-00080 | 3 | $12.00 | $4.00 FestLagerDeckel.SLDPRT | Part | 1023 Kohlenstoffstahlblech (SS)
SW-00081 | 3 | $75.00 | $25.00 FestLagerBock.SLDPRT | Part | 1023 Kohlenstoffstahlblech (SS)
SW-00082 | 3 | $30.00 | $10.00 SchraegLager10x30x14.3-Dold.SLDPRT | Part
DIN 912 M5 x 20 --- 20N | 116 | $11.60 | $0.10 DIN 912 M5 x 20 --- 20N.SLDPRT | Part
SW-00083 | 2 | $2.00 | $1.00 LagerHalterPlatteY.SLDPRT | Part
SW-00072 | 3 | $57.00 | $19.00 LosLager.SLDASM | Assembly | https://www.dold-mechatronik.de/
SW-00073 | 3 | $36.00 | $12.00 LosLagerBock.SLDPRT | Part | 1023 Kohlenstoffstahlblech (SS)
SW-00074 | 3 | $21.00 | $7.00 KugelLagerLager10x30x9-Dold.SLDPRT | Part
SW-00084 | 3 | $9.00 | $3.00 WellenKupplung6.35-8Dold.SLDPRT | Part | 1060 Legierung | https://www.dold-mechatronik.de/
SW-00075 | 2 | $100.00 | $50.00 GewindeSpindel16x5x842.SLDPRT | Part | Rostfreier Chromstahl | https://www.dold-mechatronik.de/
SW-00076 | 2 | $128.00 | $64.00 AR15-rail 960.SLDPRT | Part | 1.5714 (16NiCr4) | https://www.dold-mechatronik.de/
DIN 912 M6 x 10 --- 10N | 78 | $7.80 | $0.10 DIN 912 M6 x 10 --- 10N.SLDPRT | Part
DIN 912 M4 x 6 --- 6N | 18 | $1.80 | $0.10 DIN 912 M4 x 6 --- 6N.SLDPRT | Part
ISO - 4033 - M5 - W - N | 4 | $0.40 | $0.10 ISO - 4033 - M5 - W - N.SLDPRT | Part

Part Number | Thumbnail image | Quantity | Total Cost | Description | Cost | File Name | Type | Material | Source
Circlip DIN 471 - 10 x 1 | 3 | $0.30 | $0.10 Circlip DIN 471 - 10 x 1.SLDPRT | Part
SW-00085 | 4 | $436.00 Closed Loop Stepper 3.6 NM on X Axis, 3NM Bipolar Stepper 3NM on Y1,Y2 and Z Axis $109.00 Nema 23 Stepper Motor length
| | 93mm.SLDPRT
Part | ebay
SW-00087 | 1 | $511.30 Fräskopf | $511.30 FräskopfIsel.SLDASM | Assembly
SW-00090 | 12 | $360.00 | $30.00 ARC15FN_block.SLDPRT | Part | https://www.dold-mechatronik.de/
SW-00089 | 2 | $2.00 | $1.00 MotorHalter1.SLDPRT | Part | 1060 Legierung
SW-00092 | 1 | $250.00 | $250.00 Spindle GDZ-23.SLDPRT | Part | ebay
SW-00093 | 1 | $5.20 | $5.20 CamHalter3.SLDASM | Assembly
SW-00094 | 1 | $5.00 | $5.00 Cam.SLDPRT | Part | 1.5805 (10NiCr5-4)
SW-00095 | 1 | $0.10 | $0.10 CamHUnten.SLDPRT | Part
SW-00096 | 1 | $0.10 | $0.10 CamHOben.SLDPRT | Part
SW-00088 | 1 | $1.00 | $1.00 MotorHalterPlatteIsel.SLDPRT | Part | 1060 Legierung
SW-00091 | 2 | $2.00 | $1.00 MotorHalter2.SLDPRT | Part | 1060 Legierung
SW-00097 | 1 | $127.30 | $127.30 spannblock_-_213400.SLDASM | CATPART | https://www.dold-mechatronik.de/
SW-00099 | 1 | $48.00 | $48.00 spannblock_-_213400_01.SLDPRT | CATASM | https://www.dold-mechatronik.de/
SW-00101 | 1 | $0.10 | $0.10 spannblock_-_213400_03.SLDPRT | CATASM
SW-00100 | 1 | $0.10 | $0.10 spannblock_-_213400_04.SLDPRT | CATASM
SW-00098 | 1 | $0.10 | $0.10 spannblock_-_213400_02.SLDPRT | CATASM
SW-00102 | 1 | $79.00 Kugelgewindemutter 12x2,5mm, Einzelgangrückführung von Dold Mechatronic $79.00 GewindeMutterIsel.SLDPRT | Part | 1.4000 (X6Cr13)
DIN 912 M8 x 80 --- 28N | 4 | $0.40 | $0.10 DIN 912 M8 x 80 --- 28N.SLDPRT | Part

Part Number | Thumbnail image | Quantity | Total Cost | Description | Cost | File Name | Type | Material | Source
DIN 912 M4 x 16 --- 16N | 34 | $3.40 | $0.10 DIN 912 M4 x 16 --- 16N.SLDPRT | Part
DIN 912 M5 x 35 --- 22N | 4 | $0.40 | $0.10 DIN 912 M5 x 35 --- 22N.SLDPRT | Part
SW-00103 | 1 | $1.00 | $1.00 LaserHalter1.SLDPRT | Part
SW-00086 | 1 | $295.00 Y2 Axis | $295.00 Y2-Achse.SLDASM | Assembly
DIN 912 M4 x 10 --- 10N | 20 | $2.00 | $0.10 DIN 912 M4 x 10 --- 10N.SLDPRT | Part
SW-00021 | 1 | $1’282.20 Generic 6 Axis Controller | $1’282.20 Generic1 v77.SLDASM | Assembly
SW-00028 | 1 | $348.00 | $348.00 Boards.sldasm | Assembly
SW-00029 | 1 | $196.00 UB1 motherboard from cncroom | $196.00 UB1 v1.sldprt | Part | https://cncroom.com/en/
SW-00030 | 1 | $152.00 UC300ETH-5LPT MOtion Controller from CNCDrive | $152.00 UC300-ETH v1.sldprt | Part | https://www.cncdrive.com/
SW-00049 | 1 | $330.00 | $330.00 Driver.sldasm | Assembly
SW-00050 | 6 | $330.00 DQ542MA CNC Digital Stepper Motor Controller 50V/4.2A/128 Micro $55.00 DM542 v1.sldprt | Part | ebay
SW-00031 | 1 | $43.80 | $43.80 Stecker.sldasm | Assembly
SW-00039 | 1 | $1.20 | $1.20 Buchse2P v2.sldasm | Assembly
SW-00033 | 8 | $4.00 | $0.50 4 pin aviation f.sldprt | Part
SW-00035 | 8 | $0.80 | $0.10 4 pin aviation spring washer.sldprt | Part
SW-00034 | 8 | $4.00 | $0.50 2 pin aviation f plastic.sldprt | Part
SW-00036 | 8 | $0.80 | $0.10 4 pin aviation nut.sldprt | Part
SW-00041 | 6 | $34.20 | $5.70 Buchse4P v2.sldasm | Assembly
SW-00043 | 6 | $3.00 | $0.50 4 pin aviation f plastic.sldprt | Part
SW-00042 | 6 | $30.00 | $5.00 4 pin aviation f-1.sldprt | Part

Part Number | Thumbnail image | Quantity | Total Cost | Description | Cost | File Name | Type | Material | Source
SW-00044 | 6 | $0.60 | $0.10 4 pin aviation spring washer-1.sldprt | Part
SW-00045 | 6 | $0.60 | $0.10 4 pin aviation nut-1.sldprt | Part
SW-00040 | 1 | $1.20 | $1.20 Buchse2P v2-1.sldasm | Assembly
SW-00047 | 1 | $1.20 | $1.20 Buchse2P v2-3.sldasm | Assembly
SW-00046 | 1 | $1.20 | $1.20 Buchse2P v2-2.sldasm | Assembly
SW-00032 | 1 | $1.20 | $1.20 Buchse2P v2-4.sldasm | Assembly
SW-00038 | 1 | $1.20 | $1.20 Buchse2P v2-7.sldasm | Assembly
SW-00037 | 1 | $1.20 | $1.20 Buchse2P v2-6.sldasm | Assembly
SW-00048 | 1 | $1.20 | $1.20 Buchse2P v2-5.sldasm | Assembly
SW-00052 | 1 | $58.40 | $58.40 Gehaeuse-Profil v40.sldasm | Assembly
SW-00053 | 4 | $20.00 | $5.00 30x30-224 v2.sldprt | Part | 3.3547 (EN-AW 5083)
SW-00068 | 1 | $1.00 | $1.00 FanDeckel.sldprt | Part
SW-00055 | 1 | $4.00 | $4.00 Hutschienen.sldasm | Assembly
SW-00056 | 2 | $4.00 | $2.00 Schiene.sldprt | Part
SW-00066 | 1 | $1.00 | $1.00 WandGeraeteStecker_1.sldprt | Part | 1060 Legierung
SW-00057 | 1 | $1.00 | $1.00 Boden.sldprt | Part
SW-00054 | 1 | $1.00 | $1.00 WandPlexi.sldprt | Part | Glas
SW-00060 | 1 | $2.40 | $2.40 Schrauben.sldasm | Assembly
SW-00062 | 16 | $1.60 | $0.10 91292A116.sldprt | Part
SW-00061 | 4 | $0.40 | $0.10 91239A412.sldprt | Part

Part Number | Thumbnail image | Quantity | Total Cost | Description | Cost | File Name | Type | Material | Source
SW-00063 | 4 | $0.40 | $0.10 9546K241.sldprt | Part
SW-00058 | 1 | $1.00 | $1.00 WandDriver.sldprt | Part | 1060 Legierung
SW-00059 | 1 | $1.00 | $1.00 WandKurz2_1.sldprt | Part | 1060 Legierung
SW-00065 | 1 | $1.00 | $1.00 Deckel.sldprt | Part | 1060 Legierung
SW-00064 | 1 | $5.00 | $5.00 power socket w fuse v1.sldprt | Part
SW-00067 | 1 | $10.00 | $10.00 E-StopAutomationDirectGCX1131 v1.sldprt | Part
SW-00069 | 1 | $10.00 | $10.00 GDSTIME 50mm x 50mm x 20mm 12V Brushless Cooling Fan v2.sldprt | Part
SW-00022 | 1 | $152.00 | $152.00 Power Supply.sldasm | Assembly
SW-00026 | 3 | $3.00 | $1.00 wago_222_5_terminal v1.sldprt | Part
SW-00024 | 2 | $90.00 48V Power Supply for Stepper | $45.00 Power Supply 48V v3.sldprt | Part | ebay
SW-00025 | 1 | $25.00 5V Power Supply | $25.00 Power Supply 5V v1.sldprt | Part | ebay
SW-00023 | 1 | $22.00 24V Power Supply for UB1 motion controller | $22.00 S-25-24 v1.sldprt | Part | ebay
SW-00027 | 1 | $12.00 12V Power Supply for Laser Module | $12.00 12V.SLDPRT | Part | ebay
SW-00051 | 1 | $350.00 Windows 11 PC für UCCNC | $350.00 MiniPC.SLDPRT | Part
SW-00007 | 1 | $65.10 Basis | $65.10 BasisGestell.SLDASM | Assembly
SW-00008 | 5 | $25.00 | $5.00 40x40-1100.SLDPRT | Part | 1060 Legierung
SW-00010 | 4 | $4.00 | $1.00 160x150x40x10.SLDPRT | Part | 1060 Legierung
SW-00011 | 1 | $2.00 | $2.00 8x70x960.SLDPRT | Part | 1060 Legierung
SW-00009 | 1 | $2.00 | $2.00 Winkel40x40x8.SLDPRT | Part | 1060 Legierung
SW-00013 | 2 | $0.20 | $0.10 Halter.SLDPRT | Part

Part Number | Thumbnail image | Quantity | Total Cost | Description | Cost | File Name | Type | Material | Source
SW-00012 | 2 | $0.20 | $0.10 SteuerungDistanzhalter.SLDPRT | Part
SW-00014 | 1 | $8.70 | $8.70 Schrauben^BasisGestell.SLDASM | Assembly
DIN 7991 - M6 x 20 --- 13.7N | 25 | $2.50 | $0.10 DIN 7991 - M6 x 20 --- 13.7N.SLDPRT | Part
DIN 912 M8 x 12 --- 12N | 12 | $1.20 | $0.10 DIN 912 M8 x 12 --- 12N.SLDPRT | Part
SW-00015 | 2 | $4.00 | $2.00 GrundgestellVerstärker.SLDPRT | Part | 1060 Legierung
SW-00017 | 1 | $3.00 | $3.00 AluBP.SLDASM | Assembly
SW-00019 | 1 | $1.00 | $1.00 AluBP150.SLDPRT | Part | 1060 Legierung
SW-00018 | 2 | $2.00 | $1.00 AluBP250.SLDPRT | Part | 1060 Legierung
SW-00016 | 3 | $45.00 | $15.00 InduktivSensor.SLDPRT | Part | https://www.dold-mechatronik.de/
SW-00020 | 1 | $1.00 | $1.00 SensorPlatte.SLDPRT | Part | 3.3547 (EN-AW 5083)
SW-00148 | 1 | $700.00 PLH3D-15W High Performance Plug&Play Laser Kit for All CNC Machines $700.00 Engraving-Laser-Head-PLH3D-15W-v1.0.0-
| | optlasers.com.SLDPRT
Part | https://optlasers.com/
SW-00104 | 1 | $571.80 X Axis | $571.80 X-AchseV1.SLDASM | Assembly
SW-00116 | 1 | $4.90 | $4.90 XSchrauben.SLDASM | Assembly
SW-00114 | 2 | $2.00 | $1.00 XMitnehmerStuetze.SLDPRT | Part
SW-00117 | 1 | $1.00 | $1.00 LagerHalterPlatte.SLDPRT | Part | 1060 Legierung
SW-00118 | 2 | $6.00 | $3.00 X-WinkelBG.SLDASM | Assembly
SW-00120 | 2 | $2.00 | $1.00 X-Platte2.SLDPRT | Part | 1060 Legierung
SW-00119 | 2 | $2.00 | $1.00 X-Platte1.SLDPRT | Part | 1060 Legierung
SW-00121 | 2 | $2.00 | $1.00 X-Winkel.SLDPRT | Part | 1060 Legierung
SW-00105 | 1 | $8.00 | $8.00 120x80-800.SLDPRT | Part | 1060 Legierung

Part Number | Thumbnail image | Quantity | Total Cost | Description | Cost | File Name | Type | Material | Source
SW-00107 | 2 | $112.00 | $56.00 AR15-rail 690.SLDPRT | Part | 1.5714 (16NiCr4)
SW-00106 | 1 | $40.00 | $40.00 GewindeSpindel16x5x652.SLDPRT | Part | Rostfreier Chromstahl
SW-00110 | 2 | $4.00 | $2.00 XYVerbinder.SLDASM | Assembly
SW-00112 | 2 | $2.00 | $1.00 XYVerbinderplatte.SLDPRT | Part | 1060 Legierung
SW-00111 | 2 | $2.00 | $1.00 XYWinkel.SLDPRT | Part
SW-00115 | 3 | $60.00 | $20.00 GewindeMutter16x5.SLDPRT | Part | 1.5714 (16NiCr4) | https://www.dold-mechatronik.de/
SW-00108 | 3 | $57.00 | $19.00 GewindeSpindelMutter.SLDPRT | Part | 1023 Kohlenstoffstahlblech (SS) https://www.dold-mechatronik.de/
SW-00113 | 2 | $2.00 | $1.00 XMitnehmerWinkel.SLDPRT | Part
SW-00109 | 2 | $2.00 | $1.00 XMitnehmerPlatte.SLDPRT | Part | 1060 Legierung
SW-00122 | 1 | $517.50 Z Axis | $517.50 Z-Isel-Spindel.SLDASM | Assembly
SW-00138 | 1 | $5.40 | $5.40 Schrauben Z Achse Komplett Isel.SLDASM | Assembly
DIN 912 M6 x 30 --- 30N | 6 | $0.60 | $0.10 DIN 912 M6 x 30 --- 30N.SLDPRT | Part
DIN 912 M4 x 30 --- 20N | 10 | $1.00 | $0.10 DIN 912 M4 x 30 --- 20N.SLDPRT | Part
DIN 912 M5 x 25 --- 25N | 16 | $1.60 | $0.10 DIN 912 M5 x 25 --- 25N.SLDPRT | Part
DIN 912 M6 x 40 --- 24N | 4 | $0.40 | $0.10 DIN 912 M6 x 40 --- 24N.SLDPRT | Part
DIN 912 M4 x 40 --- 20N | 4 | $0.40 | $0.10 DIN 912 M4 x 40 --- 20N.SLDPRT | Part
SW-00141 | 1 | $115.10 | $115.10 Nema23mitHalter.SLDASM | Assembly
DIN 912 M5 x 50 --- 22N | 4 | $0.40 | $0.10 DIN 912 M5 x 50 --- 22N.SLDPRT | Part
SW-00142 | 1 | $3.70 | $3.70 L30xD25 CouplerASM 6to8.SLDASM | Assembly | https://www.dold-mechatronik.de/

Part Number | Thumbnail image | Quantity | Total Cost | Description | Cost | File Name | Type | Material | Source
SW-00146 | 2 | $0.20 | $0.10 M3x12_Screw.SLDPRT | Part
SW-00143 | 1 | $2.00 | $2.00 Coupler_A.SLDPRT | Part
SW-00144 | 1 | $0.50 | $0.50 Dampener.SLDPRT | Part
SW-00145 | 1 | $1.00 | $1.00 Coupler_B.SLDPRT | Part
SW-00147 | 2 | $2.00 | $1.00 Nema23HalterFuss.SLDPRT | Part | 3.3547 (EN-AW 5083)
SW-00127 | 1 | $1.00 | $1.00 LosLagerHalterIsel.SLDPRT | Part | 3.3547 (EN-AW 5083)
SW-00128 | 1 | $1.00 | $1.00 FestLagerHalterIsel.SLDPRT | Part | 3.3547 (EN-AW 5083)
SW-00140 | 1 | $37.00 | $37.00 kugelgewindespindeln-
| | | 211122_20352.SLDPRT
CATPART | Werkstoff CF 53, induktiv
gehärtet | https://www.dold-mechatronik.de/
SW-00126 | 1 | $2.00 | $2.00 FestLagerBlock.SLDPRT | Part | 3.3547 (EN-AW 5083)
SW-00139 | 1 | $1.00 | $1.00 SensorPlatteZ.SLDPRT | Part | 3.3547 (EN-AW 5083)
SW-00123 | 1 | $1.00 | $1.00 ZFuehrungsHalter.SLDPRT | Part | 3.3547 (EN-AW 5083)
SW-00125 | 2 | $48.00 | $24.00 AR15-rail 270.SLDPRT | Part | 1.5714 (16NiCr4)
SW-00124 | 2 | $2.00 | $1.00 ZXVerbinder.SLDPRT | Part | 1060 Legierung
SW-00133 | 1 | $75.00 Flanschlager an Antriebsseite für Spindel Ø12mm, eckig von Dold Mechatronic $75.00 flanschlager_-_216504_0030.SLDASM | CATPART | https://www.dold-mechatronik.de/
SW-00136 | 1 | $20.00 | $20.00 flanschlager_-_216504_0030_02.SLDPRT | CATASM
SW-00135 | 1 | $20.00 | $20.00 flanschlager_-_216504_0030_01.SLDPRT | CATASM
SW-00134 | 1 | $15.00 | $15.00 flanschlager_-_216504_0030_04.SLDPRT | CATASM
SW-00137 | 1 | $20.00 | $20.00 flanschlager_-_216504_0030_03.SLDPRT | CATASM
SW-00129 | 1 | $55.00 Flanschlager an Loslagerseite für Spindel Ø12mm von Dold Mechatronic $55.00 flanschlager_-_216504_0032.SLDASM | CATPART | https://www.dold-mechatronik.de/

Part Number | Thumbnail image | Quantity | Total Cost | Description | Cost | File Name | Type | Material | Source
SW-00132 | 1 | $15.00 | $15.00 flanschlager_-_216504_0032_02.SLDPRT | CATASM
SW-00130 | 1 | $20.00 | $20.00 flanschlager_-_216504_0032_01.SLDPRT | CATASM
SW-00131 | 1 | $20.00 | $20.00 flanschlager_-_216504_0032_03.SLDPRT | CATASM
