mallemann/mycnc/bom/v4-bom-single-level.pdf

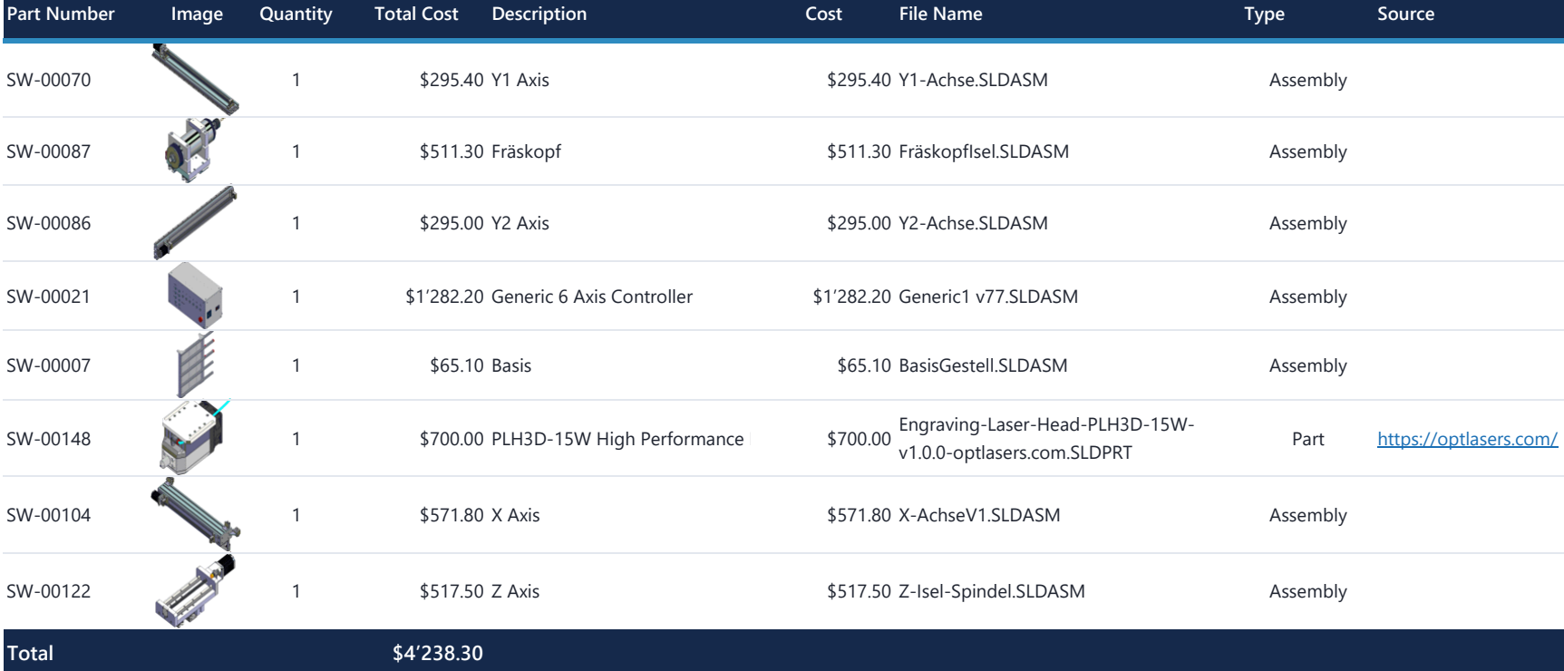
[picture p48: figure]
Part Number; Image; Quantity; Total Cost; Description; Cost; File Name; Type; Source; $295.40 Y1 Axis; $295.40 Y1-Achse.SLDASM; Assembly; $511.30 Fräskopf; $511.30 FräskopfIsel.SLDASM; $295.00 Y2 Axis; $295.00 Y2-Achse.SLDASM; $1’282.20 Generic 6 Axis Controller; $1’282.20 Generic1 v77.SLDASM; $65.10 Basis; $65.10 BasisGestell.SLDASM; v1.0.0-optlasers.com.SLDPRT; Part; https://optlasers.com/; $571.80 X Axis; $571.80 X-AchseV1.SLDASM; $517.50 Z Axis; $517.50 Z-Isel-Spindel.SLDASM; Total

SW-00148 | 1 | $700.00 PLH3D-15W High Performance Plug&Play Laser Kit for All CNC Machines $700.00 Engraving-Laser-Head-PLH3D-15W-
