mallemann/mycnc/bom/v1-cost-purchased-parts.pdf

Part | Quantity | Cost | Total (CHF)
Welle (Linear guide shafts, Silberstahl poliert), 600mm | 6 | 10.00 | 60.00
Welle12Z (Linear guide shafts, Silberstahl poliert), 200mm | 2 | 6.00 | 12.00
Linear Bearings SCS12UU | 16 | 4.00 | 64.00
Alu Profil 90x45 Nut 10 | 2 | 36.00 | 72.00
Bodenplatte (Working Plate, Wood 12mm) | 1 | 15.00 | 15.00
Grundplatte (Base Plate, wood 12mm) | 1 | 24.00 | 24.00
RadialLager10x5x4 | 18 | 3.10 | 55.80
RadialLager13x6x5 | 2 | 3.00 | 6.00
AxialLager13x6x5 | 2 | 4.00 | 8.00
ZahnriemenT5 B10 56z 280mm (Toothbelt) | 3 | 15.00 | 45.00
ZahnriemenT5 B10 1000mm (Tootbelt) | 3 | 15.00 | 45.00
T510z10 ( (Belt Wheel Type T, T5, B10) | 14 | 7.00 | 98.00
T548z10 (Belt Wheel Type T, T5, B10) | 3 | 16.00 | 48.00
TrapezSpindel10x3 | 1 | 12.00 | 12.00
TrapezGewindeMutter 10x3 | 1 | 13.00 | 13.00
EndSchalter (End Switch) | 4 | 2.50 | 10.00
Power supply (from old PC) | 1 | - | -
Raspberry PI 2 Model B (1GB) | 1 | 45.00 | 45.00
Raspberry Pi CNC Board / Hat V2.51 - GRBL Compatable | 1 | 38.00 | 38.00
Nema17 Stepper Motor | 4 | 35.00 | 140.00
Stepper Motor Servo Driver A4988 | 4 | 7.00 | 28.00
Spindle Motor 400W incl. Collet, Driver, Power Supply | 1 | 230.00 | 230.00
Total | | | 1'068.80

## Costs of non printed parts
