mallemann/mycnc/bom/v3-bom-structure.pdf

Pos | Name | Quantity | Pos | Name | Quantity
1 | Gestell | 1 | 4 | Y-Achse-2 | 1
| Alu Profil 90x45 Nut 10 | 2 | | WellenHalterLoslagerY | 1
| BodenPlatte | 1 | | Rillenkugellager10x30x9 | 1
| Grundplatte | 1 | | GewindeSpindel16x5 | 1
| FestLagerHalter1 | 1 | | WellenHalterFestlagerY | 1
| FestLagerHalter2 | 1 | | Schraegkugellager10x30x14.3 | 1
2 | Y-Achse-1 | 1 | | Welle | 2
| GewindeSpindel16x5 | 1 | | MotorHalterY | 1
| WellenHalterLoslagerY | 1 | | Nema17x1Welle | 1
| Rillenkugellager10x30x9 | 1 | | T510z10 | 1
| Welle | 2 | | T548z10 | 1
| WellenHalterFestlagerY | 1 | | FestLagerHalter1 | 1
| Schraegkugellager10x30x14.3 | 1 | | FestLagerHalter2 | 1
| T548z10 | 1 | 5 | Z-Achse | 1
| MotorHalterY | 1 | | RadialLager13x6x5 | 2
| Nema17x1Welle | 1 | | AxialLager13x6x5 | 2
| T510z10 | 1 | | TrapezSpindel10x3 | 1
3 | X-Achse | 1 | | Welle12Z | 2
| GewindeMutter16x5 | 2 | | Z-Halter | 1
| SCS12UU | 8 | | LagerHalterZOben | 1
| Welle | 2 | | XPlatte | 1
| FührungsHalterFestlagerXAussen | 1 | | XWinkel | 1
| FührungsHalterFestlagerXInnen | 1 | | XTraeger | 2
| GewindeSpindel16x5 | 1 | | Nema17x1Welle | 1
| FührungsHalterLoslagerXAussen | 1 | | T510z10 | 2
| FührungsHalterLoslagerXInnen | 1 | | SCS12UU | 8
| LoslagerX | 1 | | GewindeMutter16x5 | 1
| Rillenkugellager10x30x9 | 1 | | Motor | 1
| FestlagerX | 1 | | Halter2 | 1
| Schraegkugellager10x30x14.3 | 1 | | Halter1 | 1
| MotorHalterX | 1 | | Motor55 | 1
| T548z10 | 1 | | TrapezGewindeMutter10x3 | 1
| Nema17x1Welle | 1 | | ZHeber | 1
| T510z10 | 1
