mallemann/mycnc/bom/v4-purchased-parts-raspberry.pdf

Artikel | Menge Lieferant | Einzelpreis | Total

Summe
Lieferant

Summe
Lieferant CHF
Div. Alu Profile | | http://www.metallladen.ch/ | | | | CHF | 250.00
Div. Schrauben | | | | | | CHF | 180.00
| | http://www.alprofil.ch/
Profile | 5 | 40x40 L1100 | CHF | 18.21 CHF 91.05
2 | 120x40 L960 | CHF | 41.62 CHF 83.24
1 | 120x80 L800 | CHF | 66.80 CHF 66.80
Nutsteine | 70 | Profil 8 M4 | CHF | 0.40 CHF 28.00
70 | Profil 8 M5 | CHF | 0.40 CHF 28.00
70 | Profil 8 M6 | CHF | 0.40 CHF 28.00 CHF 325.09 CHF | 325.09
| | https://www.dold-mechatronik.de
Linearführung | 2 | AR/HR 15 960mm | € | 63.87 € | 127.74
| 2 | AR/HR 15 690 | € | 46.85 € | 93.70
| 8 | Linearwagen ARC 15 FN | € | 25.21 € | 201.68 € | 423.12 CHF | 465.43
www.ebway.ch | maxonic1990
Spindle Motor | 1 | 400W Spindle Motor ER11 & PWM &Power Supply | CHF | 180.00 CHF 180.00 CHF 180.00 CHF | 180.00
| | https://www.dold-mechatronik.de
Kugelspindeln | 2 | SFU1605 DM 842mm | € | 72.27 € | 144.54
| 1 | SFU1605 DM 652mm | € | 63.87 € | 63.87
| 3 | Festlager | € | 19.96 € | 59.88
| 3 | Loslager | € | 11.90 € | 35.70
| 4 | WellenKupplungen | € | 5.30 € | 21.20
Trapezspindel | 1 | Trapezspindel mit Mutter Z Achse | € | 15.00 € | 15.00
| 2 | Schrägkugellager Z Achse | € | 5.00 € | 10.00
| 1 | Nema 23 Z Achse | € | 25.00 € | 25.00 € | 375.19 CHF | 412.71
www.ebay.ch | mechapro
Schrittmotor | 3 | Nema 23 | € | 39.00 € | 117.00 € | 117.00 CHF | 128.70
www.ebay.ch | protoneer
Controller | 1 Raspberry PI | CHF | 48.00 CHF 48.00
1 CNC Hat | CHF | 33.00 CHF 33.00 CHF 81.00 CHF | 81.00
Total | CHF 2'022.93
