mallemann/mycnc/bom/v4-purchased-parts-uc300eth-ub1.pdf

Artikel | Menge | Lieferant | Einzelpreis | Total

Summe
Lieferant

Summe
Lieferant CHF
Div. Alu Profile | http://www.metallladen.ch/ | CHF 250.00
Div. Schrauben | | CHF 180.00
| | http://www.alprofil.ch/
Profile | 5 | 40x40 L1100 | CHF 18.21 | CHF 91.05
| 2 | 120x40 L960 | CHF 41.62 | CHF 83.24
| 1 | 120x80 L800 | CHF 66.80 | CHF 66.80
Nutsteine | 70 | Profil 8 M4 | CHF 0.40 | CHF 28.00
| 70 | Profil 8 M5 | CHF 0.40 | CHF 28.00
| 70 | Profil 8 M6 | CHF 0.40 | CHF 28.00 | CHF 325.09 | CHF 325.09
| | https://www.dold-mechatronik.de
Linearführung | 2 | AR/HR 15 960mm | € 63.87 | € 127.74
| 2 | AR/HR 15 690 | € 46.85 | € 93.70
| 8 | Linearwagen ARC 15 FN | € 25.21 | € 201.68 | € 423.12 | CHF 465.43
| | www.ebay.ch
Spindle Motor | 1 | 1.5Kw Spindle Air Cooled incl. VFD 400Hz | CHF 300.00 | CHF 300.00 | CHF 300.00 | CHF 300.00
| | https://www.dold-mechatronik.de
Kugelspindeln | 2 | SFU1605 DM 842mm | € 72.27 | € 144.54
| 1 | SFU1605 DM 652mm | € 63.87 | € 63.87
| 3 | Festlager | € 19.96 | € 59.88
| 3 | Loslager | € 11.90 | € 35.70
| 4 | WellenKupplungen | € 5.30 | € 21.20
Trapezspindel | 1 | Trapezspindel mit Mutter Z Achse | € 15.00 | € 15.00
| 2 | Schrägkugellager Z Achse | € 5.00 | € 10.00
| 1 | Nema 23 Z Achse 1.5Nm | € 60.00 | € 60.00 | € 410.19 | CHF 451.21
Endschalter | 3 | Induktive Endschalter | € 20.00 | € 60.00 | € 60.00 | CHF 66.00
| | www.ebay.ch | mechapro
Schrittmotor | 3 | Nema 23 X/Y/Y' - 1.5Nm | € 60.00 | € 180.00 | € 180.00 | CHF 198.00
| | http://cncdrive.com/
Controller | 1 | UCCNC | CHF 70.00 | € 70.00 | € 70.00 | CHF 77.00

| www.cncroom.com
1 | UC300 ETH & UB1 | CHF 310.00 | € 310.00 | € 310.00 | CHF 341.00
| www.ebay.ch
6 | Stepper Driver DQ 542 MA | CHF 40.00 | € 240.00 | € 240.00 | CHF 264.00
| www.orbsmart.de/
1 | Mini PC / W10 | CHF 200.00 | € 200.00 | € 200.00 | CHF 220.00
Total | CHF 3'137.73
