mallemann/mycnc/bom/v1-bom-quantities.pdf

BENENNUNG | MENGE
Welle | 6
SCS12UU | 16
PlatteOben | 3
Alu Profil 90x45 Nut 10 | 2
BodenPlatte | 1
Grundplatte | 1
WellenBock | 4
WellenBockUnten | 4
RiemenKlemmeUnten | 2
RiemenKlemmBügel | 4
RiemenKlemmeUntenL | 2
WellenBockOben | 2
MotorHolder | 3
T510z10 | 14
Nema17x1Welle | 4
T548z10 | 3
WellePullyOben | 3
WellePulleyUnten | 6
TrägerOben | 4
RadialLager10x5x4 | 18
Fuss | 3
ZahnriemenT5 10 3x56z & 3x 1m | 3
RiemenklemmerY | 4
RiemenklemmerDec kelY | 4
SpannerX | 2
PlatteX | 2
WellenBockObenXZ | 1
WellenLagerZ | 1
Welle12Z | 2
TrapezSpindel10x3 | 1
RadialLager13x6x5 | 2
AxialLager13x6x5 | 2
WerkzeugEndPlatteZUn ten | 1
TrapezGewindeMutter 10x3 | 1
WerkzeugEndPlatteZO ben | 1
MotorHolderZ | 1
MotorLinkZ | 1
WerkzeugHalterPlatte | 1
EndSchalter | 2
Power supply | 1
Raspberry PI 2 Model B (1GB) | 1

## Total Mengen / Quantities

Raspberry PI CNC Hat

1
Servo Driver

4
Spindle Motor

1
