mallemann/mycnc/(list of files, cad)

Other CAD files:
cad/step/MyCNC_V4.step
