mallemann/mycnc/(commit log)

2026-10-25 Sync Z-axis variants and specs with masdrive
2026-10-25 Add V4 bills of materials
2026-10-25 Update V4 bills of materials
2026-10-25 Add V4 structured BOM with costs
    [v4-structured-bom-with-costs.xlsx]
2026-10-25 Document CAD sources and release downloads
2026-10-25 Add STEP export of V4 and update CAD docs
    [MyCNC_V4.step]
2026-10-26 docs(cnc-router): replace complete V4 photo, add Z-axis note
